ukiddingbitch/ESP32c3/docs/revD.png

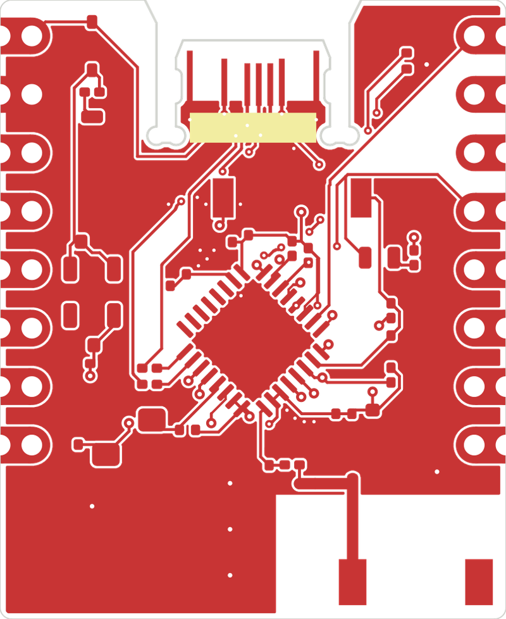
docs/revD.png
