ukiddingbitch/ESP32c3/esp32c3mini-MIFA-F4/esp32c3mini-BOM.csv

Comment | Designator | Footprint | LCSC Part #
GRM033R61A104KE15D | C1 | C_0201_0603Metric | C76934
CL03A105KQ3CSNC | C2 | C_0201_0603Metric | C318541
GRM033R61A104KE15D | C3 | C_0201_0603Metric | C76934
CL03A105KQ3CSNC | C4 | C_0201_0603Metric | C318541
CL05A106MP5NUNC | C5 | C_0402_1005Metric | C315248
GRM0335C1H1R5BA01D | C6 | C_0201_0603Metric | C161414
GRM033R61A104KE15D | C7 | C_0201_0603Metric | C76934
CL03A105KQ3CSNC | C8 | C_0201_0603Metric | C318541
GRM033R61A104KE15D | C9 | C_0201_0603Metric | C76934
CL03A105KQ3CSNC | C10 | C_0201_0603Metric | C318541
GJM0335C1E220JB01D | C11 | C_0201_0603Metric | C237453
GJM0335C1E220JB01D | C12 | C_0201_0603Metric | C237453
CL03A105KQ3CSNC | C13 | C_0201_0603Metric | C318541
CL05A106MP5NUNC | C14 | C_0402_1005Metric | C315248
CL05A106MP5NUNC | C15 | C_0402_1005Metric | C315248
GRM0335C1H1R5BA01D | C16 | C_0201_0603Metric | C161414
KT-0603R | D1 | LED_0603_1608Metric | C2286
KT-0603B | D2 | LED_0603_1608Metric | C2288
BAT60JFILM | D3 | D_SOD-323 | C133103
LQP03TN2N7C02D | L1 | L_0201_0603Metric | C185546
0201WMF1002TEE | R1 | R_0201_0603Metric | C473048
0201WMF1002TEE | R2 | R_0201_0603Metric | C473048
0201WMF1002TEE | R3 | R_0201_0603Metric | C473048
0201WMF1002TEE | R4 | R_0201_0603Metric | C473048
0201WMF5101TEE | R5 | R_0201_0603Metric | C270344
0201WMF5101TEE | R6 | R_0201_0603Metric | C270344
0201WMF5101TEE | R7 | R_0201_0603Metric | C270344
0201WMF5101TEE | R8 | R_0201_0603Metric | C270344
0201WMF220JTEE | R9 | R_0201_0603Metric | C270355
0201WMF220JTEE | R10 | R_0201_0603Metric | C270355
B3U-1000P | SW1 | SW_SPST_B3U-1000P | C231329
B3U-1000P | SW2 | SW_SPST_B3U-1000P | C231329
ESP32-C3FH4 | U1 | QFN-32-1EP_5x5mm_P0.5mm_EP3.45x3.45mm | C2858491
ME6211C33M5G-N | U2 | SOT-23-5 | C82942
X322540MPB4SI | Y1 | Crystal_SMD_3225-4Pin_3.2x2.5mm | C9010
