ukiddingbitch/ESP32c3/esp32c3mini-MIFA-F4/panel/models/D_SOD-323.step

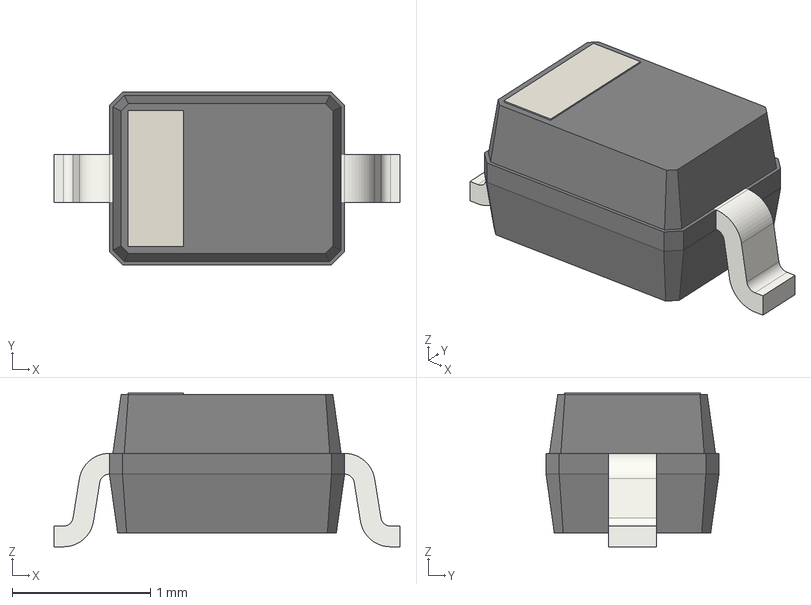
[picture p3: CAD file, 2026-11-11]
esp32c3mini-MIFA-F4/panel/models/D_SOD-323.step
2.50 x 1.25 x 1.11 mm
