ukiddingbitch/ESP32c3/esp32c3mini-MIFA-F4/panel/models/L_0201_0603Metric.step

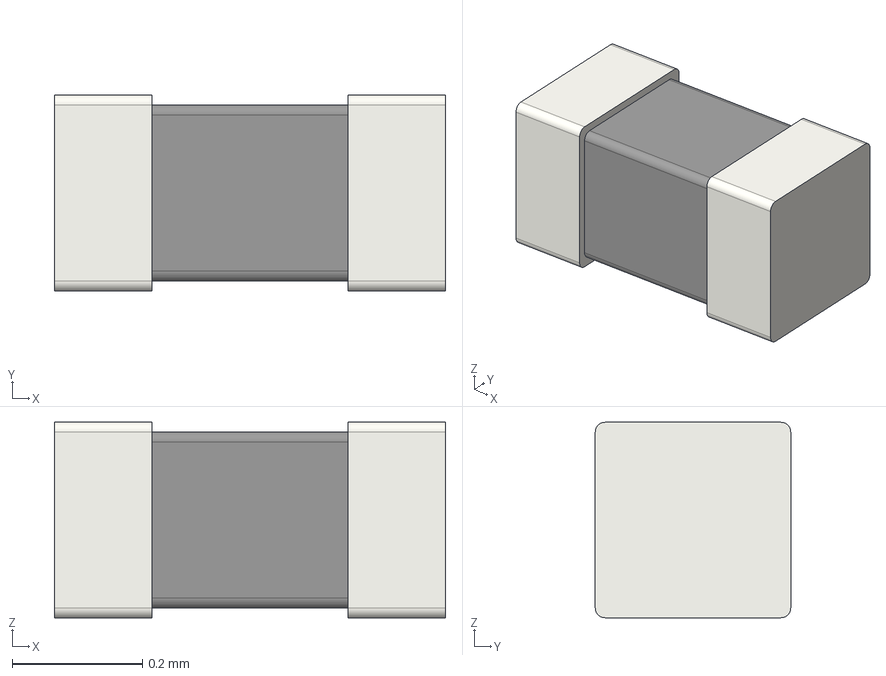
[picture p4: CAD file, 2026-11-11]
esp32c3mini-MIFA-F4/panel/models/L_0201_0603Metric.step
0.6 x 0.3 x 0.3 mm
