ukiddingbitch/ESP32c3/esp32c3mini-MIFA-F4/panel/models/QFN-32-1EP_5x5mm_P0.5mm_EP3.45x3.45mm.step

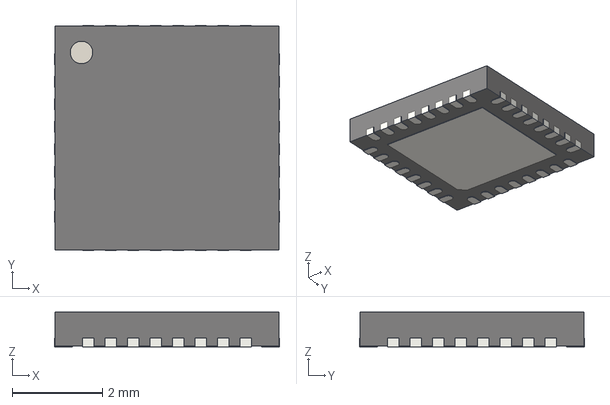
[picture p5: CAD file, 2026-11-11]
esp32c3mini-MIFA-F4/panel/models/QFN-32-1EP_5x5mm_P0.5mm_EP3.45x3.45mm.step
5.00 x 5.00 x 0.77 mm
