ukiddingbitch/ESP32c3/esp32c3mini-MIFA-F4/panel/models/SW_SPST_B3U-1000P.step

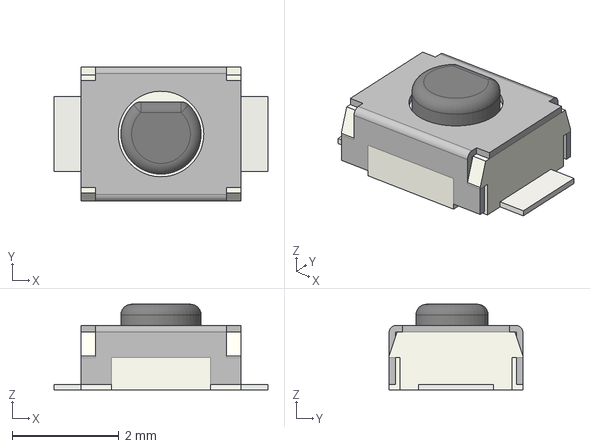
[picture p6: CAD file, 2026-11-11]
esp32c3mini-MIFA-F4/panel/models/SW_SPST_B3U-1000P.step
4.00 x 2.50 x 1.60 mm
