ukiddingbitch/ESP32c3/esp32c3mini-MIFA-F4/panel/models/Crystal_SMD_3225-4Pin_3.2x2.5mm.step

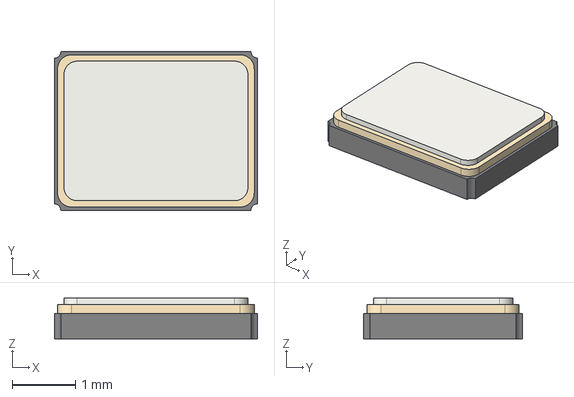
[picture p7: CAD file, 2026-11-11]
esp32c3mini-MIFA-F4/panel/models/Crystal_SMD_3225-4Pin_3.2x2.5mm.step
3.20 x 2.50 x 0.64 mm
