ukiddingbitch/ESP32c3/esp32c3mini-MIFA-F4/panel/models/R_0201_0603Metric.step

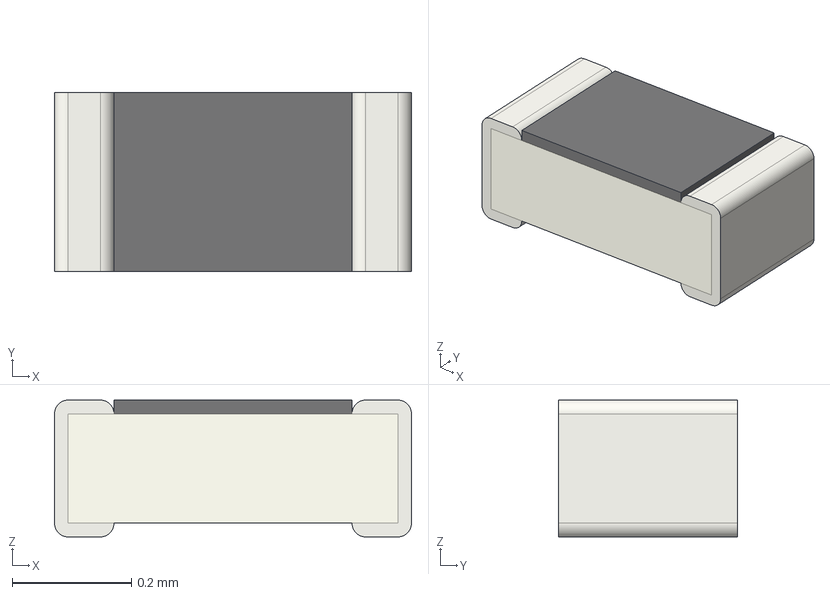
[picture p8: CAD file, 2026-11-11]
esp32c3mini-MIFA-F4/panel/models/R_0201_0603Metric.step
0.6 x 0.3 x 0.23 mm
