ukiddingbitch/ESP32c3/esp32c3mini-MIFA-F4/panel/models/SOT-23-5.step

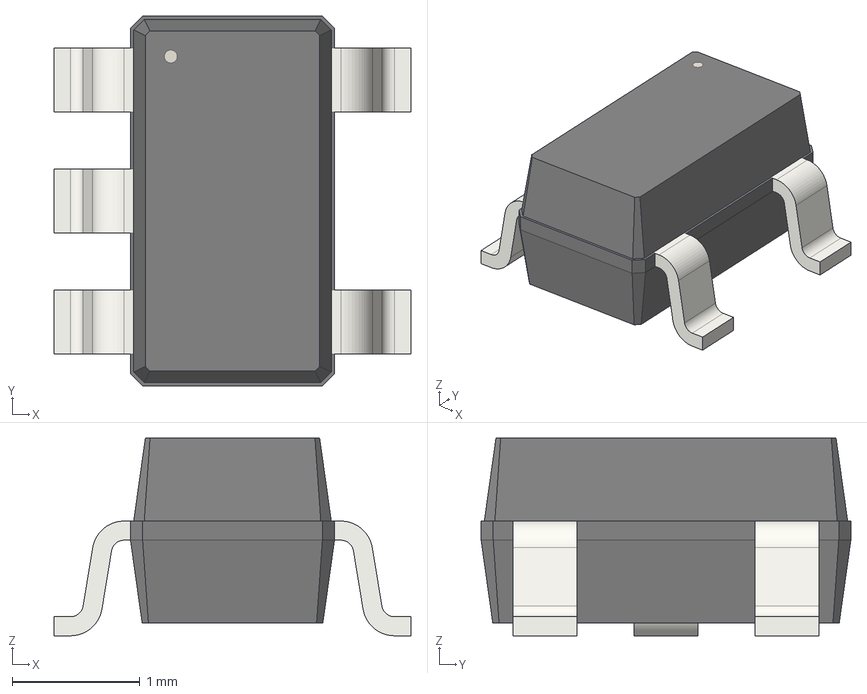
[picture p9: CAD file, 2026-11-11]
esp32c3mini-MIFA-F4/panel/models/SOT-23-5.step
2.80 x 2.90 x 1.55 mm
