ukiddingbitch/ESP32c3/esp32c3mini-MIFA-F4/panel/models/C_0402_1005Metric.step

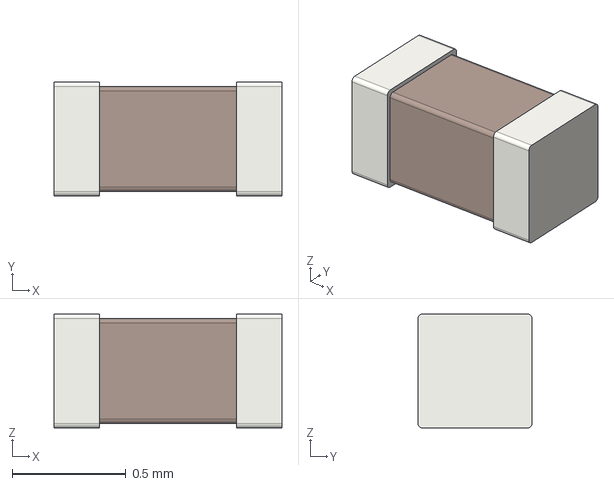
[picture p10: CAD file, 2026-11-11]
esp32c3mini-MIFA-F4/panel/models/C_0402_1005Metric.step
1.00 x 0.5 x 0.5 mm
