ukiddingbitch/ESP32c3/esp32c3mini-MIFA-F4/panel/models/LED_0603_1608Metric.step

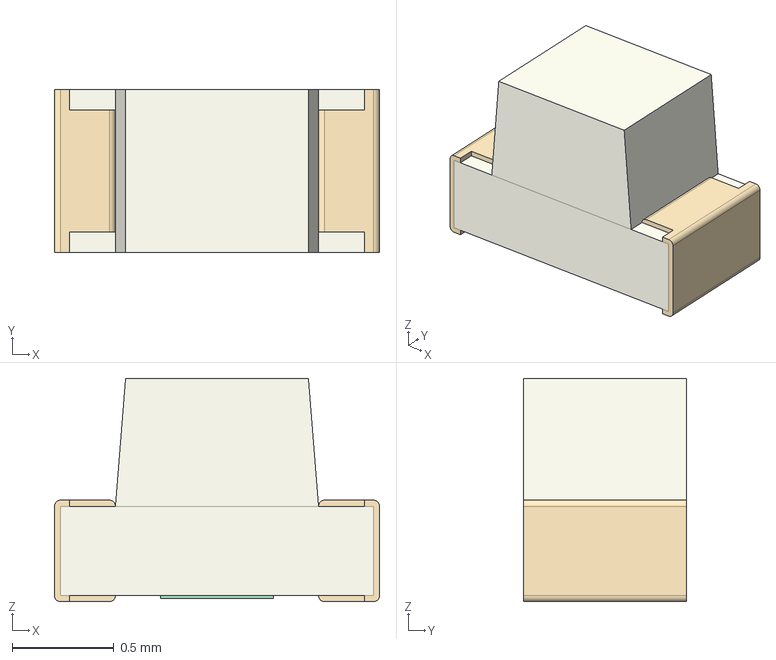
[picture p11: CAD file, 2026-11-11]
esp32c3mini-MIFA-F4/panel/models/LED_0603_1608Metric.step
1.60 x 0.8 x 1.10 mm
