ukiddingbitch/ESP32c3/(list of files, cad)

Other CAD files:
esp32c3mini-MIFA-F4/panel/models/C_0201_0603Metric.step
