ukiddingbitch/ESP32c3/esp32c3mini-MIFA-F4/esp32c3mini.kicad_pcb

## KiCad design esp32c3mini-MIFA-F4/esp32c3mini.kicad_pcb (2026-11-11)

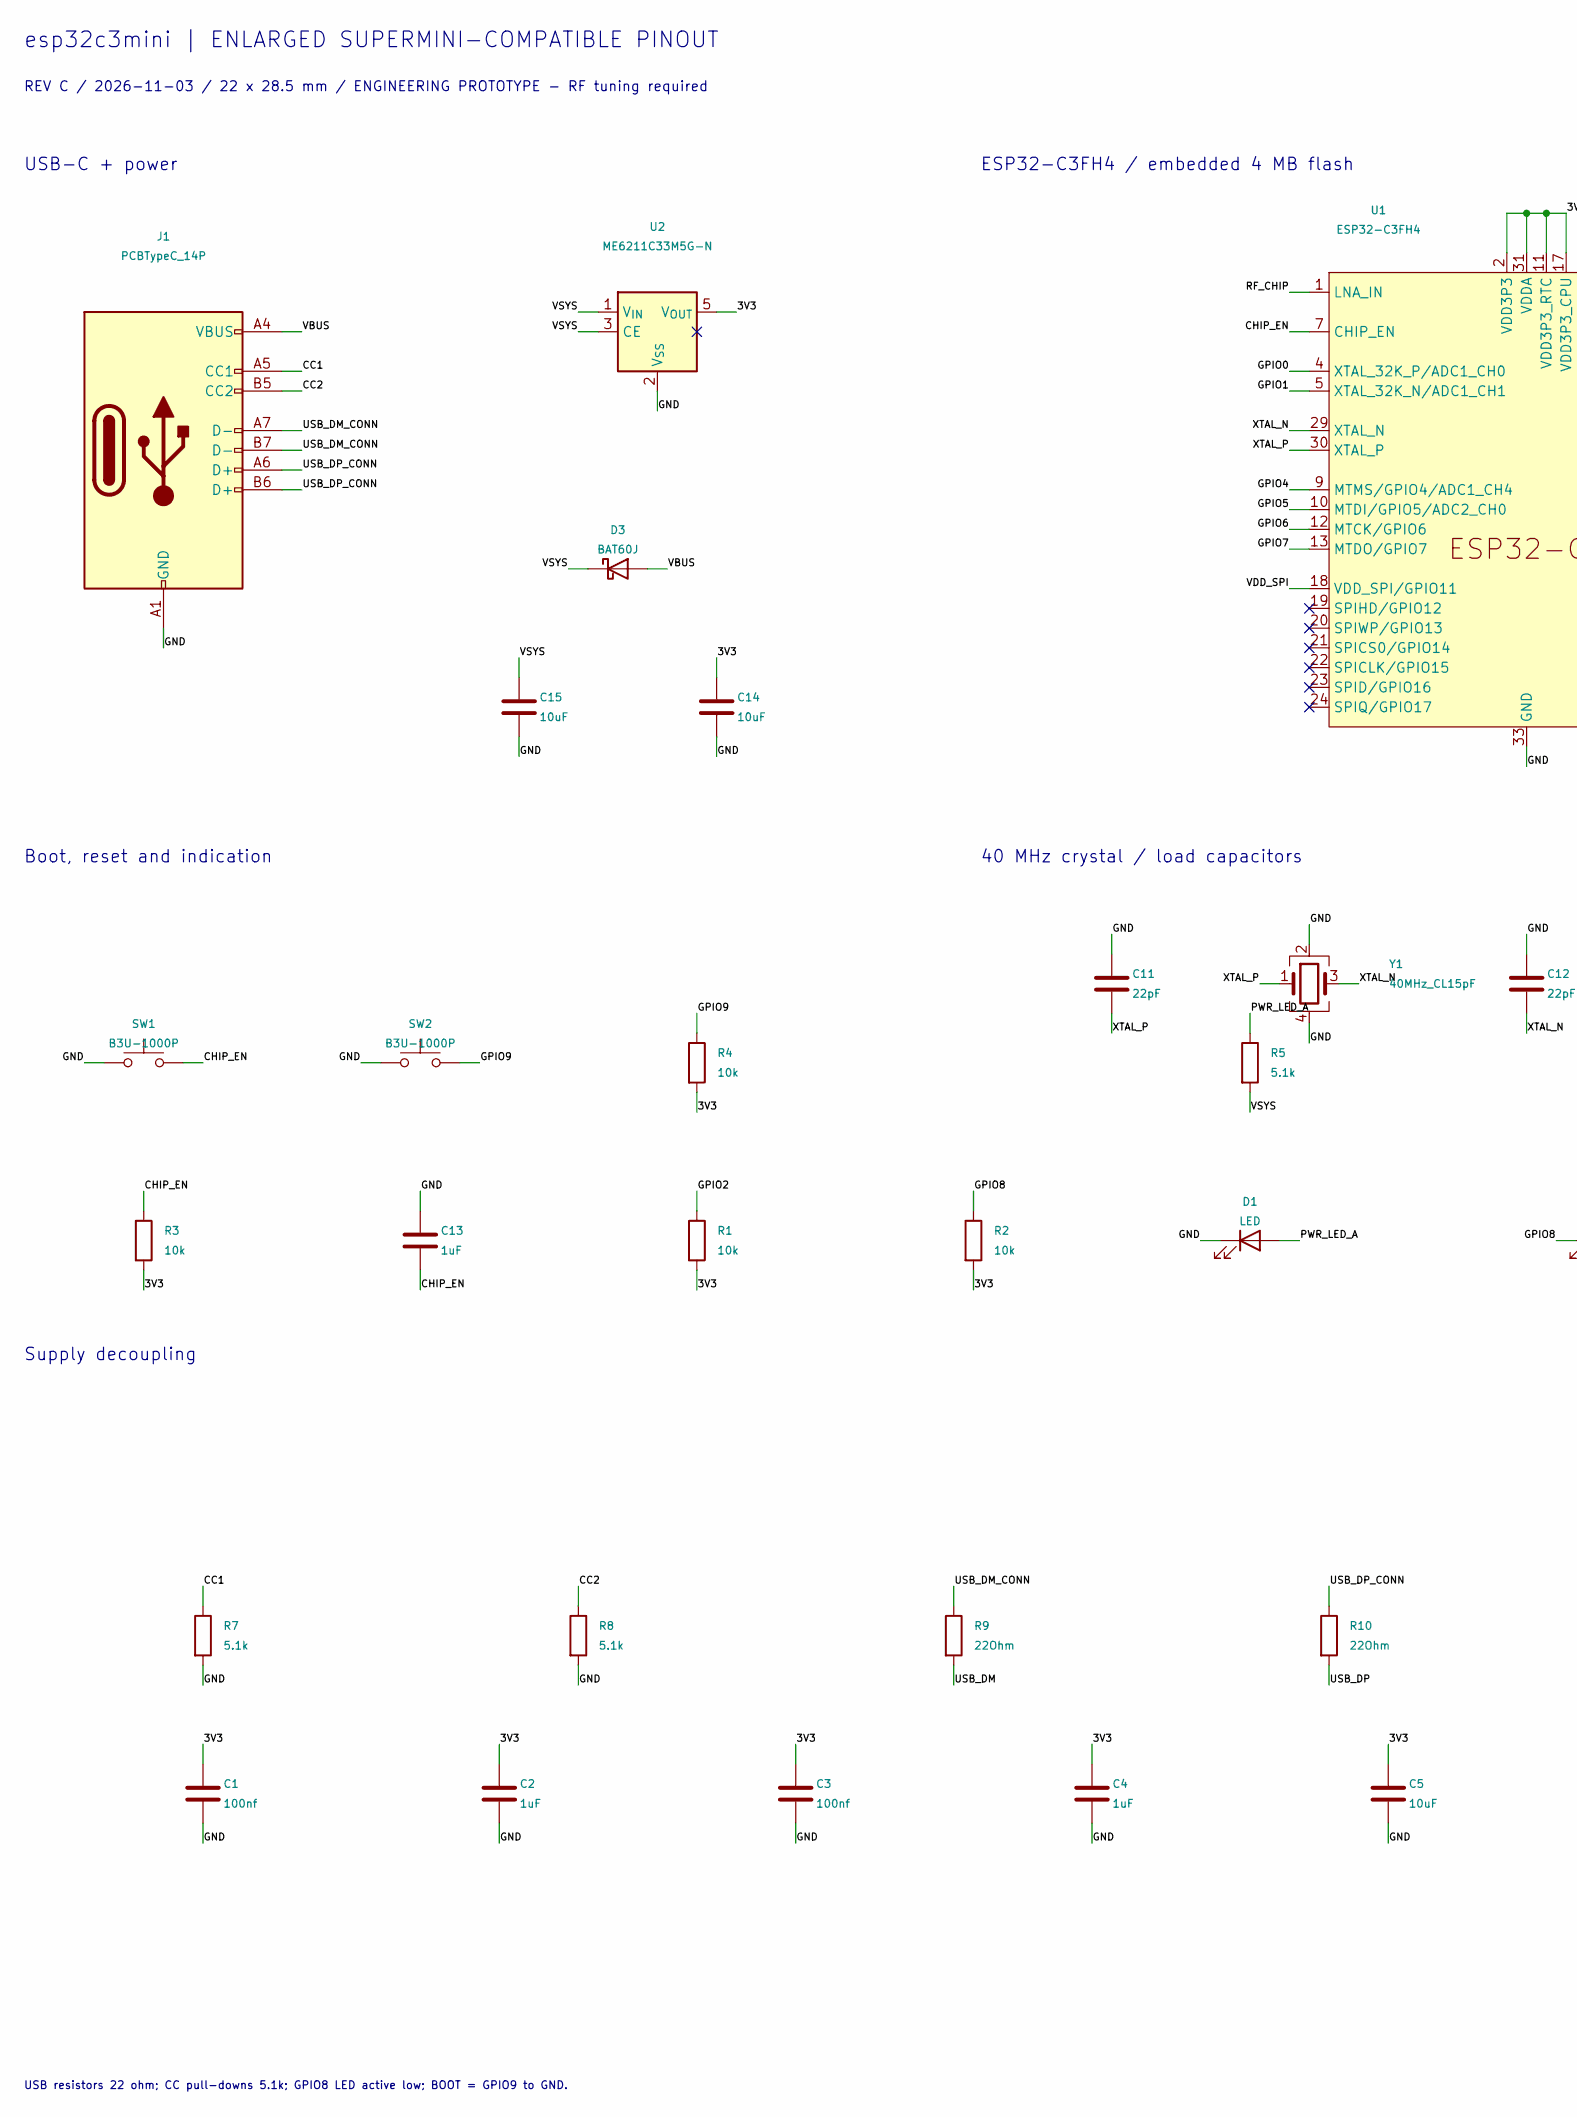
[picture p12: schematic esp32c3mini.kicad_sch, esp32c3mini | REV C enlarged prototype, part in row 1, column 1]

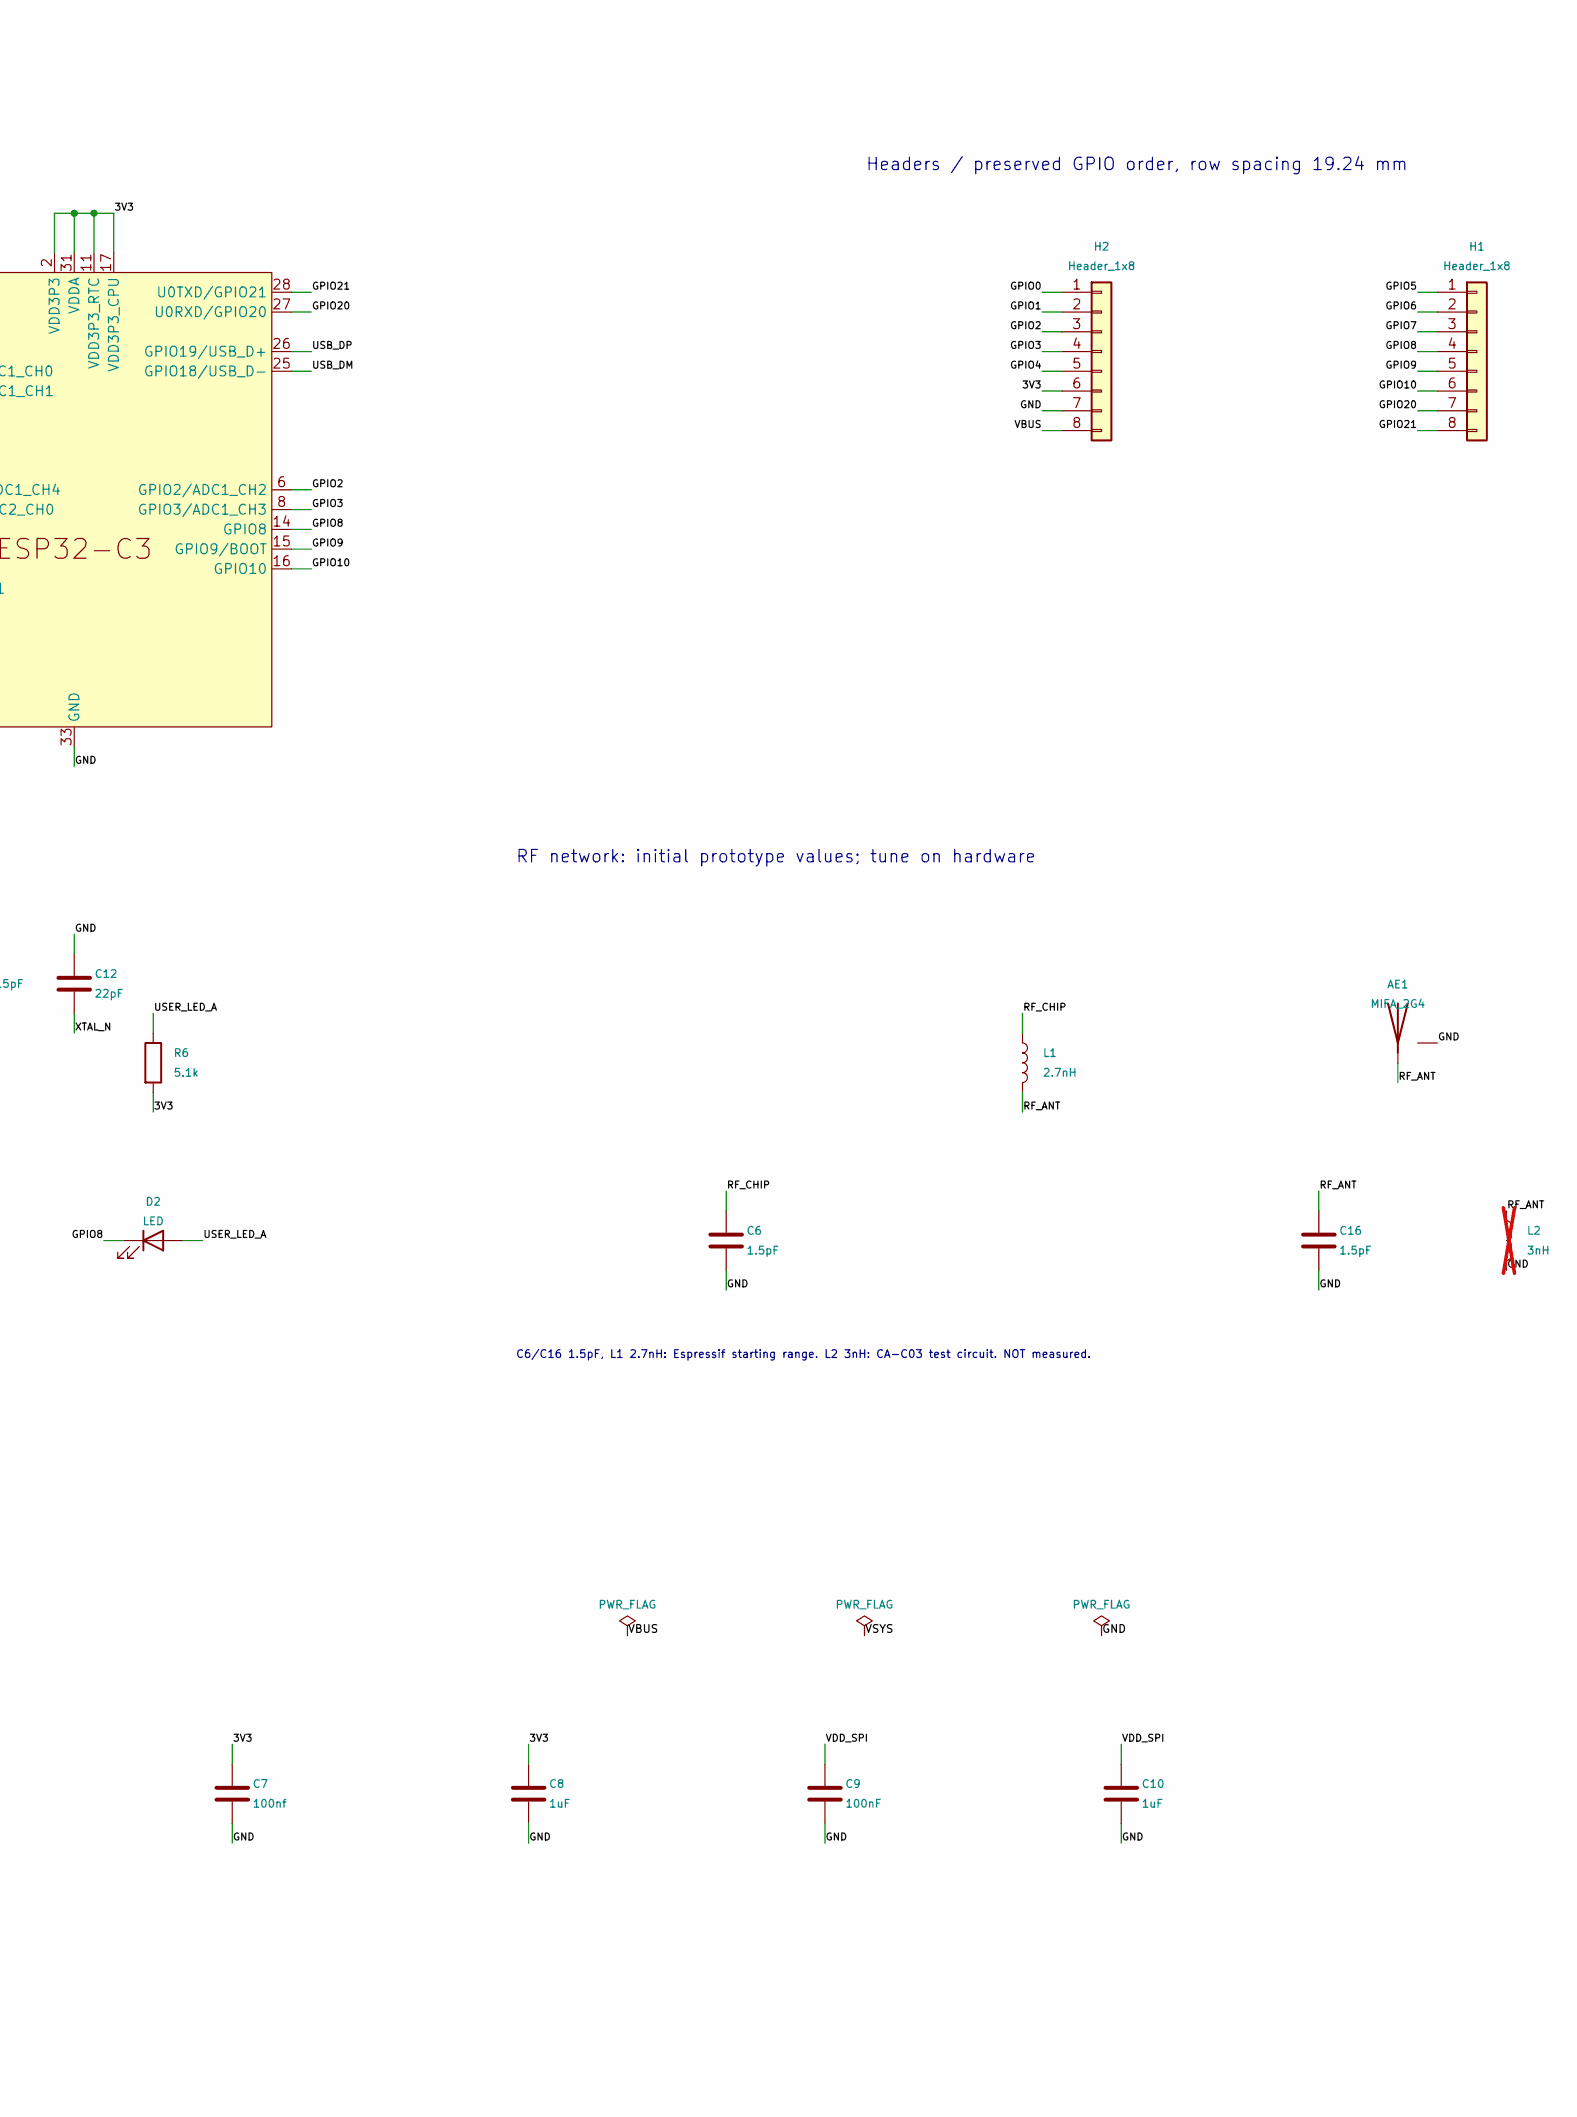
[picture p13: schematic esp32c3mini.kicad_sch, esp32c3mini | REV C enlarged prototype, part in row 1, column 2]

Parts:
AE1: MIFA_2G4; Texas_SWRA117D_2.4GHz_Right
C1, C3, C7: 100nf; C_0201_0603Metric; MPN GRM033R61A104KE15D; LCSC C76934
C2, C4, C8, C10, C13: 1uF; C_0201_0603Metric; MPN CL03A105KQ3CSNC; LCSC C318541
C5, C14, C15: 10uF; C_0402_1005Metric; MPN CL05A106MP5NUNC; LCSC C315248
C6, C16: 1.5pF; C_0201_0603Metric; MPN GRM0335C1H1R5BA01D; LCSC C161414
C9: 100nF; C_0201_0603Metric; MPN GRM033R61A104KE15D; LCSC C76934
C11, C12: 22pF; C_0201_0603Metric; MPN GJM0335C1E220JB01D; LCSC C237453
D1: LED; LED_0603_1608Metric; MPN KT-0603R; LCSC C2286
D2: LED; LED_0603_1608Metric; MPN KT-0603B; LCSC C2288
D3: BAT60J; D_SOD-323; MPN BAT60JFILM; LCSC C133103
H1: Header_1x8; Header_Right
H2: Header_1x8; Header_Left
J1: PCBTypeC_14P; MPN PCB_EDGE_CONTACTS
L1: 2.7nH; L_0201_0603Metric; MPN LQP03TN2N7C02D; LCSC C185546
L2: 3nH; L_0201_0603Metric; MPN LQP03TN3N0C02D; LCSC C162614; not fitted
R1, R2, R3, R4: 10k; R_0201_0603Metric; MPN 0201WMF1002TEE; LCSC C473048
R5, R6, R7, R8: 5.1k; R_0201_0603Metric; MPN 0201WMF5101TEE; LCSC C270344
R9, R10: 22Ohm; R_0201_0603Metric; MPN 0201WMF220JTEE; LCSC C270355
SW1, SW2: B3U-1000P; SW_SPST_B3U-1000P; MPN B3U-1000P; LCSC C231329
U1: ESP32-C3FH4; QFN-32-1EP_5x5mm_P0.5mm_EP3.45x3.45mm; MPN ESP32-C3FH4; LCSC C2858491
U2: ME6211C33M5G-N; SOT-23-5; MPN ME6211C33M5G-N; LCSC C82942
Y1: 40MHz_CL15pF; Crystal_SMD_3225-4Pin_3.2x2.5mm; MPN X322540MPB4SI; LCSC C9010

Connections:
/3V3: C1.1, C2.1, C3.1, C4.1, C5.1, C7.1, C8.1, C14.1, H2.6, R1.2, R2.2, R3.2, R4.2, R6.2, U1.2 (VDD3P3), U1.3 (VDD3P3), U1.11 (VDD3P3_RTC), U1.17 (VDD3P3_CPU), U1.31 (VDDA), U1.32 (VDDA), U2.5 (V_{OUT})
/CC1: J1.A5 (CC1), R7.1
/CC2: J1.B5 (CC2), R8.1
/CHIP_EN: C13.2, R3.1, SW1.2, U1.7 (CHIP_EN)
/GND: AE1.2 (GND), C1.2, C2.2, C3.2, C4.2, C5.2, C6.2, C7.2, C8.2, C9.2, C10.2, C11.1, C12.1, C13.1, C14.2, C15.2, C16.2, D1.1 (K), H2.7, J1.A1 (GND), J1.A12 (GND), J1.B1 (GND), J1.B12 (GND), L2.2, R7.2, R8.2, SW1.1, SW2.1, U1.33 (GND), U2.2 (V_{SS}), Y1.2, Y1.4
/GPIO0: H2.1, U1.4 (XTAL_32K_P/ADC1_CH0)
/GPIO1: H2.2, U1.5 (XTAL_32K_N/ADC1_CH1)
/GPIO2: H2.3, R1.1, U1.6 (GPIO2/ADC1_CH2)
/GPIO3: H2.4, U1.8 (GPIO3/ADC1_CH3)
/GPIO4: H2.5, U1.9 (MTMS/GPIO4/ADC1_CH4)
/GPIO5: H1.1, U1.10 (MTDI/GPIO5/ADC2_CH0)
/GPIO6: H1.2, U1.12 (MTCK/GPIO6)
/GPIO7: H1.3, U1.13 (MTDO/GPIO7)
/GPIO8: D2.1 (K), H1.4, R2.1, U1.14 (GPIO8)
/GPIO9: H1.5, R4.1, SW2.2, U1.15 (GPIO9/BOOT)
/GPIO10: H1.6, U1.16 (GPIO10)
/GPIO20: H1.7, U1.27 (U0RXD/GPIO20)
/GPIO21: H1.8, U1.28 (U0TXD/GPIO21)
/PWR_LED_A: D1.2 (A), R5.1
/RF_ANT: AE1.1 (A), C16.1, L1.2, L2.1
/RF_CHIP: C6.1, L1.1, U1.1 (LNA_IN)
/USB_DM: R9.2, U1.25 (GPIO18/USB_D-)
/USB_DM_CONN: J1.A7 (D-), J1.B7 (D-), R9.1
/USB_DP: R10.2, U1.26 (GPIO19/USB_D+)
/USB_DP_CONN: J1.A6 (D+), J1.B6 (D+), R10.1
/USER_LED_A: D2.2 (A), R6.1
/VBUS: D3.2 (A), H2.8, J1.A4 (VBUS), J1.A9 (VBUS), J1.B4 (VBUS), J1.B9 (VBUS)
/VDD_SPI: C9.1, C10.1, U1.18 (VDD_SPI/GPIO11)
/VSYS: C15.1, D3.1 (K), R5.2, U2.1 (V_{IN}), U2.3 (CE)
/XTAL_N: C12.2, U1.29 (XTAL_N), Y1.3
/XTAL_P: C11.2, U1.30 (XTAL_P), Y1.1

Notes on the sheet:
esp32c3mini | ENLARGED SUPERMINI-COMPATIBLE PINOUT
REV C / 2026-11-03 / 22 x 28.5 mm / ENGINEERING PROTOTYPE - RF tuning required
USB-C + power
ESP32-C3FH4 / embedded 4 MB flash
Headers / preserved GPIO order, row spacing 19.24 mm
Boot, reset and indication
40 MHz crystal / load capacitors
RF network: initial prototype values; tune on hardware
Supply decoupling
C6/C16 1.5pF, L1 2.7nH: Espressif starting range. L2 3nH: CA-C03 test circuit. NOT measured.
USB resistors 22 ohm; CC pull-downs 5.1k; GPIO8 LED active low; BOOT = GPIO9 to GND.

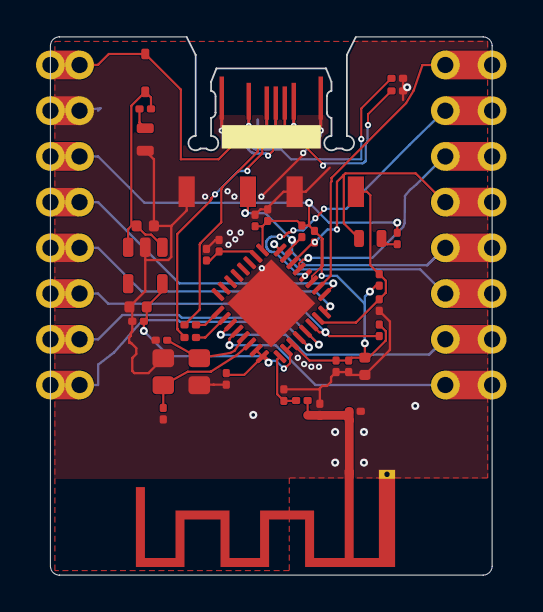
[picture p14: board esp32c3mini.kicad_pcb from above]

Board: 2 copper layers, 24.5 x 29.9 mm, 40 parts (0 on the bottom side), 31 nets.
