ukiddingbitch/ESP32c3/esp32c3mini-MIFA-F4/panel/esp32c3mini-panel.kicad_pcb

## KiCad design esp32c3mini-MIFA-F4/panel/esp32c3mini-panel.kicad_pcb (2026-11-11)

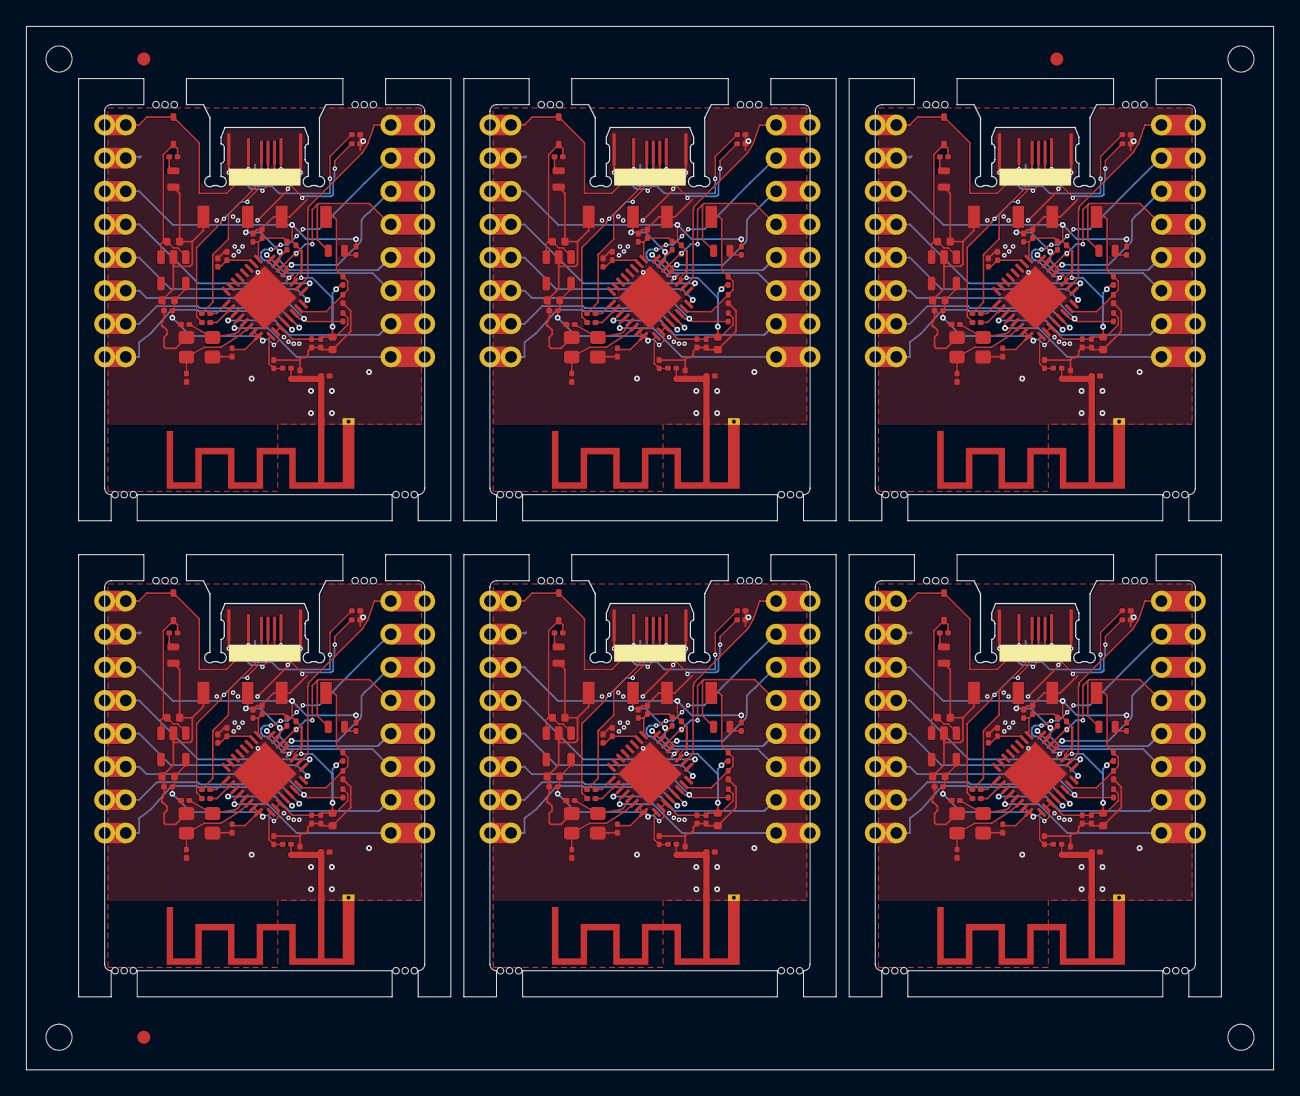
[picture p15: board esp32c3mini-panel.kicad_pcb from above]

Board: 2 copper layers, 95.6 x 80.0 mm, 319 parts (0 on the bottom side), 186 nets.

Parts:
AE101, AE201, AE301, AE401, AE501, AE601: MIFA_2G4; Texas_SWRA117D_2.4GHz_Right
C101, C103, C107, C201, C203, C207, C301, C303, C307, C401, C403, C407, C501, C503, C507, C601, C603, C607: 100nf; C_0201_0603Metric
C102, C104, C108, C110, C113, C202, C204, C208, C210, C213, C302, C304, C308, C310, C313, C402, C404, C408, C410, C413, C502, C504, C508, C510, C513, C602, C604, C608, C610, C613: 1uF; C_0201_0603Metric
C105, C114, C115, C205, C214, C215, C305, C314, C315, C405, C414, C415, C505, C514, C515, C605, C614, C615: 10uF; C_0402_1005Metric
C106, C116, C206, C216, C306, C316, C406, C416, C506, C516, C606, C616: 1.5pF; C_0201_0603Metric
C109, C209, C309, C409, C509, C609: 100nF; C_0201_0603Metric
C111, C112, C211, C212, C311, C312, C411, C412, C511, C512, C611, C612: 22pF; C_0201_0603Metric
D101, D102, D201, D202, D301, D302, D401, D402, D501, D502, D601, D602: LED; LED_0603_1608Metric
D103, D203, D303, D403, D503, D603: BAT60J; D_SOD-323
FID1, FID2, FID3: Fiducial
H101, H201, H301, H401, H501, H601: Header_1x8; Header_Right
H102, H202, H302, H402, H502, H602: Header_1x8; Header_Left
J101, J201, J301, J401, J501, J601: PCBTypeC_14P
L101, L201, L301, L401, L501, L601: 2.7nH; L_0201_0603Metric
L102, L202, L302, L402, L502, L602: 3nH; L_0201_0603Metric
MB1_0.23_135_0, MB1_0.23_135_1, MB1_0.23_135_2, MB1_3.365_106_0, MB1_3.365_106_1, MB1_3.365_106_2, MB1_18.635_106_0, MB1_18.635_106_1, MB1_18.635_106_2, MB1_21.77_135_0, MB1_21.77_135_1, MB1_21.77_135_2, MB2_0.23_135_0, MB2_0.23_135_1, MB2_0.23_135_2, MB2_3.365_106_0, MB2_3.365_106_1, MB2_3.365_106_2, MB2_18.635_106_0, MB2_18.635_106_1, MB2_18.635_106_2, MB2_21.77_135_0, MB2_21.77_135_1, MB2_21.77_135_2, MB3_0.23_135_0, MB3_0.23_135_1, MB3_0.23_135_2, MB3_3.365_106_0, MB3_3.365_106_1, MB3_3.365_106_2, MB3_18.635_106_0, MB3_18.635_106_1, MB3_18.635_106_2, MB3_21.77_135_0, MB3_21.77_135_1, MB3_21.77_135_2, MB4_0.23_172_0, MB4_0.23_172_1, MB4_0.23_172_2, MB4_3.365_142_0, MB4_3.365_142_1, MB4_3.365_142_2, MB4_18.635_142_0, MB4_18.635_142_1, MB4_18.635_142_2, MB4_21.77_172_0, MB4_21.77_172_1, MB4_21.77_172_2, MB5_0.23_172_0, MB5_0.23_172_1, MB5_0.23_172_2, MB5_3.365_142_0, MB5_3.365_142_1, MB5_3.365_142_2, MB5_18.635_142_0, MB5_18.635_142_1, MB5_18.635_142_2, MB5_21.77_172_0, MB5_21.77_172_1, MB5_21.77_172_2, MB6_0.23_172_0, MB6_0.23_172_1, MB6_0.23_172_2, MB6_3.365_142_0, MB6_3.365_142_1, MB6_3.365_142_2, MB6_18.635_142_0, MB6_18.635_142_1, MB6_18.635_142_2, MB6_21.77_172_0, MB6_21.77_172_1, MB6_21.77_172_2: NPTH; NPTH_0.5
R101, R102, R103, R104, R201, R202, R203, R204, R301, R302, R303, R304, R401, R402, R403, R404, R501, R502, R503, R504, R601, R602, R603, R604: 10k; R_0201_0603Metric
R105, R106, R107, R108, R205, R206, R207, R208, R305, R306, R307, R308, R405, R406, R407, R408, R505, R506, R507, R508, R605, R606, R607, R608: 5.1k; R_0201_0603Metric
R109, R110, R209, R210, R309, R310, R409, R410, R509, R510, R609, R610: 22Ohm; R_0201_0603Metric
SW101, SW102, SW201, SW202, SW301, SW302, SW401, SW402, SW501, SW502, SW601, SW602: B3U-1000P; SW_SPST_B3U-1000P
TH1, TH2, TH3, TH4: NPTH; NPTH_2
U101, U201, U301, U401, U501, U601: ESP32-C3FH4; QFN-32-1EP_5x5mm_P0.5mm_EP3.45x3.45mm
U102, U202, U302, U402, U502, U602: ME6211C33M5G-N; SOT-23-5
Y101, Y201, Y301, Y401, Y501, Y601: 40MHz_CL15pF; Crystal_SMD_3225-4Pin_3.2x2.5mm

Connections:
/B1/3V3: C101.1, C102.1, C103.1, C104.1, C105.1, C107.1, C108.1, C114.1, H102.6, R101.2, R102.2, R103.2, R104.2, R106.2, U101.2, U101.3, U101.11, U101.17, U101.31, U101.32, U102.5
/B1/CC1: J101.A5, R107.1
/B1/CC2: J101.B5, R108.1
/B1/CHIP_EN: C113.2, R103.1, SW101.2, U101.7
/B1/GND: AE101.2, C101.2, C102.2, C103.2, C104.2, C105.2, C106.2, C107.2, C108.2, C109.2, C110.2, C111.1, C112.1, C113.1, C114.2, C115.2, C116.2, D101.1, H102.7, J101.A1, J101.A12, J101.B1, J101.B12, L102.2, R107.2, R108.2, SW101.1, SW102.1, U101.33, U102.2, Y101.2, Y101.4
/B1/GPIO0: H102.1, U101.4
/B1/GPIO1: H102.2, U101.5
/B1/GPIO2: H102.3, R101.1, U101.6
/B1/GPIO3: H102.4, U101.8
/B1/GPIO4: H102.5, U101.9
/B1/GPIO5: H101.1, U101.10
/B1/GPIO6: H101.2, U101.12
/B1/GPIO7: H101.3, U101.13
/B1/GPIO8: D102.1, H101.4, R102.1, U101.14
/B1/GPIO9: H101.5, R104.1, SW102.2, U101.15
/B1/GPIO10: H101.6, U101.16
/B1/GPIO20: H101.7, U101.27
/B1/GPIO21: H101.8, U101.28
/B1/PWR_LED_A: D101.2, R105.1
/B1/RF_ANT: AE101.1, C116.1, L101.2, L102.1
/B1/RF_CHIP: C106.1, L101.1, U101.1
/B1/USB_DM: R109.2, U101.25
/B1/USB_DM_CONN: J101.A7, J101.B7, R109.1
/B1/USB_DP: R110.2, U101.26
/B1/USB_DP_CONN: J101.A6, J101.B6, R110.1
/B1/USER_LED_A: D102.2, R106.1
/B1/VBUS: D103.2, H102.8, J101.A4, J101.A9, J101.B4, J101.B9
/B1/VDD_SPI: C109.1, C110.1, U101.18
/B1/VSYS: C115.1, D103.1, R105.2, U102.1, U102.3
/B1/XTAL_N: C112.2, U101.29, Y101.3
/B1/XTAL_P: C111.2, U101.30, Y101.1
/B2/3V3: C201.1, C202.1, C203.1, C204.1, C205.1, C207.1, C208.1, C214.1, H202.6, R201.2, R202.2, R203.2, R204.2, R206.2, U201.2, U201.3, U201.11, U201.17, U201.31, U201.32, U202.5
/B2/CC1: J201.A5, R207.1
/B2/CC2: J201.B5, R208.1
/B2/CHIP_EN: C213.2, R203.1, SW201.2, U201.7
/B2/GND: AE201.2, C201.2, C202.2, C203.2, C204.2, C205.2, C206.2, C207.2, C208.2, C209.2, C210.2, C211.1, C212.1, C213.1, C214.2, C215.2, C216.2, D201.1, H202.7, J201.A1, J201.A12, J201.B1, J201.B12, L202.2, R207.2, R208.2, SW201.1, SW202.1, U201.33, U202.2, Y201.2, Y201.4
/B2/GPIO0: H202.1, U201.4
/B2/GPIO1: H202.2, U201.5
/B2/GPIO2: H202.3, R201.1, U201.6
/B2/GPIO3: H202.4, U201.8
/B2/GPIO4: H202.5, U201.9
/B2/GPIO5: H201.1, U201.10
/B2/GPIO6: H201.2, U201.12
/B2/GPIO7: H201.3, U201.13
/B2/GPIO8: D202.1, H201.4, R202.1, U201.14
/B2/GPIO9: H201.5, R204.1, SW202.2, U201.15
/B2/GPIO10: H201.6, U201.16
/B2/GPIO20: H201.7, U201.27
/B2/GPIO21: H201.8, U201.28
/B2/PWR_LED_A: D201.2, R205.1
/B2/RF_ANT: AE201.1, C216.1, L201.2, L202.1
/B2/RF_CHIP: C206.1, L201.1, U201.1
/B2/USB_DM: R209.2, U201.25
/B2/USB_DM_CONN: J201.A7, J201.B7, R209.1
/B2/USB_DP: R210.2, U201.26
/B2/USB_DP_CONN: J201.A6, J201.B6, R210.1
/B2/USER_LED_A: D202.2, R206.1
/B2/VBUS: D203.2, H202.8, J201.A4, J201.A9, J201.B4, J201.B9
/B2/VDD_SPI: C209.1, C210.1, U201.18
/B2/VSYS: C215.1, D203.1, R205.2, U202.1, U202.3
/B2/XTAL_N: C212.2, U201.29, Y201.3
/B2/XTAL_P: C211.2, U201.30, Y201.1
/B3/3V3: C301.1, C302.1, C303.1, C304.1, C305.1, C307.1, C308.1, C314.1, H302.6, R301.2, R302.2, R303.2, R304.2, R306.2, U301.2, U301.3, U301.11, U301.17, U301.31, U301.32, U302.5
/B3/CC1: J301.A5, R307.1
/B3/CC2: J301.B5, R308.1
/B3/CHIP_EN: C313.2, R303.1, SW301.2, U301.7
/B3/GND: AE301.2, C301.2, C302.2, C303.2, C304.2, C305.2, C306.2, C307.2, C308.2, C309.2, C310.2, C311.1, C312.1, C313.1, C314.2, C315.2, C316.2, D301.1, H302.7, J301.A1, J301.A12, J301.B1, J301.B12, L302.2, R307.2, R308.2, SW301.1, SW302.1, U301.33, U302.2, Y301.2, Y301.4
/B3/GPIO0: H302.1, U301.4
/B3/GPIO1: H302.2, U301.5
/B3/GPIO2: H302.3, R301.1, U301.6
/B3/GPIO3: H302.4, U301.8
/B3/GPIO4: H302.5, U301.9
/B3/GPIO5: H301.1, U301.10
/B3/GPIO6: H301.2, U301.12
/B3/GPIO7: H301.3, U301.13
/B3/GPIO8: D302.1, H301.4, R302.1, U301.14
/B3/GPIO9: H301.5, R304.1, SW302.2, U301.15
/B3/GPIO10: H301.6, U301.16
/B3/GPIO20: H301.7, U301.27
/B3/GPIO21: H301.8, U301.28
/B3/PWR_LED_A: D301.2, R305.1
/B3/RF_ANT: AE301.1, C316.1, L301.2, L302.1
/B3/RF_CHIP: C306.1, L301.1, U301.1
/B3/USB_DM: R309.2, U301.25
/B3/USB_DM_CONN: J301.A7, J301.B7, R309.1
/B3/USB_DP: R310.2, U301.26
/B3/USB_DP_CONN: J301.A6, J301.B6, R310.1
/B3/USER_LED_A: D302.2, R306.1
/B3/VBUS: D303.2, H302.8, J301.A4, J301.A9, J301.B4, J301.B9
/B3/VDD_SPI: C309.1, C310.1, U301.18
/B3/VSYS: C315.1, D303.1, R305.2, U302.1, U302.3
/B3/XTAL_N: C312.2, U301.29, Y301.3
/B3/XTAL_P: C311.2, U301.30, Y301.1
/B4/3V3: C401.1, C402.1, C403.1, C404.1, C405.1, C407.1, C408.1, C414.1, H402.6, R401.2, R402.2, R403.2, R404.2, R406.2, U401.2, U401.3, U401.11, U401.17, U401.31, U401.32, U402.5
/B4/CC1: J401.A5, R407.1
/B4/CC2: J401.B5, R408.1
/B4/CHIP_EN: C413.2, R403.1, SW401.2, U401.7
/B4/GND: AE401.2, C401.2, C402.2, C403.2, C404.2, C405.2, C406.2, C407.2, C408.2, C409.2, C410.2, C411.1, C412.1, C413.1, C414.2, C415.2, C416.2, D401.1, H402.7, J401.A1, J401.A12, J401.B1, J401.B12, L402.2, R407.2, R408.2, SW401.1, SW402.1, U401.33, U402.2, Y401.2, Y401.4
/B4/GPIO0: H402.1, U401.4
/B4/GPIO1: H402.2, U401.5
/B4/GPIO2: H402.3, R401.1, U401.6
/B4/GPIO3: H402.4, U401.8
/B4/GPIO4: H402.5, U401.9
/B4/GPIO5: H401.1, U401.10
/B4/GPIO6: H401.2, U401.12
/B4/GPIO7: H401.3, U401.13
/B4/GPIO8: D402.1, H401.4, R402.1, U401.14
/B4/GPIO9: H401.5, R404.1, SW402.2, U401.15
/B4/GPIO10: H401.6, U401.16
/B4/GPIO20: H401.7, U401.27
/B4/GPIO21: H401.8, U401.28
/B4/PWR_LED_A: D401.2, R405.1
/B4/RF_ANT: AE401.1, C416.1, L401.2, L402.1
/B4/RF_CHIP: C406.1, L401.1, U401.1
/B4/USB_DM: R409.2, U401.25
/B4/USB_DM_CONN: J401.A7, J401.B7, R409.1
/B4/USB_DP: R410.2, U401.26
/B4/USB_DP_CONN: J401.A6, J401.B6, R410.1
/B4/USER_LED_A: D402.2, R406.1
/B4/VBUS: D403.2, H402.8, J401.A4, J401.A9, J401.B4, J401.B9
/B4/VDD_SPI: C409.1, C410.1, U401.18
/B4/VSYS: C415.1, D403.1, R405.2, U402.1, U402.3
/B4/XTAL_N: C412.2, U401.29, Y401.3
/B4/XTAL_P: C411.2, U401.30, Y401.1
/B5/3V3: C501.1, C502.1, C503.1, C504.1, C505.1, C507.1, C508.1, C514.1, H502.6, R501.2, R502.2, R503.2, R504.2, R506.2, U501.2, U501.3, U501.11, U501.17, U501.31, U501.32, U502.5
/B5/CC1: J501.A5, R507.1
/B5/CC2: J501.B5, R508.1
/B5/CHIP_EN: C513.2, R503.1, SW501.2, U501.7
/B5/GND: AE501.2, C501.2, C502.2, C503.2, C504.2, C505.2, C506.2, C507.2, C508.2, C509.2, C510.2, C511.1, C512.1, C513.1, C514.2, C515.2, C516.2, D501.1, H502.7, J501.A1, J501.A12, J501.B1, J501.B12, L502.2, R507.2, R508.2, SW501.1, SW502.1, U501.33, U502.2, Y501.2, Y501.4
/B5/GPIO0: H502.1, U501.4
/B5/GPIO1: H502.2, U501.5
/B5/GPIO2: H502.3, R501.1, U501.6
/B5/GPIO3: H502.4, U501.8
/B5/GPIO4: H502.5, U501.9
/B5/GPIO5: H501.1, U501.10
/B5/GPIO6: H501.2, U501.12
/B5/GPIO7: H501.3, U501.13
/B5/GPIO8: D502.1, H501.4, R502.1, U501.14
/B5/GPIO9: H501.5, R504.1, SW502.2, U501.15
/B5/GPIO10: H501.6, U501.16
/B5/GPIO20: H501.7, U501.27
/B5/GPIO21: H501.8, U501.28
/B5/PWR_LED_A: D501.2, R505.1
/B5/RF_ANT: AE501.1, C516.1, L501.2, L502.1
/B5/RF_CHIP: C506.1, L501.1, U501.1
/B5/USB_DM: R509.2, U501.25
/B5/USB_DM_CONN: J501.A7, J501.B7, R509.1
/B5/USB_DP: R510.2, U501.26
/B5/USB_DP_CONN: J501.A6, J501.B6, R510.1
/B5/USER_LED_A: D502.2, R506.1
/B5/VBUS: D503.2, H502.8, J501.A4, J501.A9, J501.B4, J501.B9
/B5/VDD_SPI: C509.1, C510.1, U501.18
/B5/VSYS: C515.1, D503.1, R505.2, U502.1, U502.3
/B5/XTAL_N: C512.2, U501.29, Y501.3
/B5/XTAL_P: C511.2, U501.30, Y501.1
/B6/3V3: C601.1, C602.1, C603.1, C604.1, C605.1, C607.1, C608.1, C614.1, H602.6, R601.2, R602.2, R603.2, R604.2, R606.2, U601.2, U601.3, U601.11, U601.17, U601.31, U601.32, U602.5
/B6/CC1: J601.A5, R607.1
/B6/CC2: J601.B5, R608.1
/B6/CHIP_EN: C613.2, R603.1, SW601.2, U601.7
/B6/GND: AE601.2, C601.2, C602.2, C603.2, C604.2, C605.2, C606.2, C607.2, C608.2, C609.2, C610.2, C611.1, C612.1, C613.1, C614.2, C615.2, C616.2, D601.1, H602.7, J601.A1, J601.A12, J601.B1, J601.B12, L602.2, R607.2, R608.2, SW601.1, SW602.1, U601.33, U602.2, Y601.2, Y601.4
/B6/GPIO0: H602.1, U601.4
/B6/GPIO1: H602.2, U601.5
/B6/GPIO2: H602.3, R601.1, U601.6
/B6/GPIO3: H602.4, U601.8
/B6/GPIO4: H602.5, U601.9
/B6/GPIO5: H601.1, U601.10
/B6/GPIO6: H601.2, U601.12
/B6/GPIO7: H601.3, U601.13
/B6/GPIO8: D602.1, H601.4, R602.1, U601.14
/B6/GPIO9: H601.5, R604.1, SW602.2, U601.15
/B6/GPIO10: H601.6, U601.16
/B6/GPIO20: H601.7, U601.27
/B6/GPIO21: H601.8, U601.28
/B6/PWR_LED_A: D601.2, R605.1
/B6/RF_ANT: AE601.1, C616.1, L601.2, L602.1
/B6/RF_CHIP: C606.1, L601.1, U601.1
/B6/USB_DM: R609.2, U601.25
/B6/USB_DM_CONN: J601.A7, J601.B7, R609.1
/B6/USB_DP: R610.2, U601.26
/B6/USB_DP_CONN: J601.A6, J601.B6, R610.1
/B6/USER_LED_A: D602.2, R606.1
/B6/VBUS: D603.2, H602.8, J601.A4, J601.A9, J601.B4, J601.B9
/B6/VDD_SPI: C609.1, C610.1, U601.18
/B6/VSYS: C615.1, D603.1, R605.2, U602.1, U602.3
/B6/XTAL_N: C612.2, U601.29, Y601.3
/B6/XTAL_P: C611.2, U601.30, Y601.1
