ukiddingbitch/ESP32c3/(notices)

Notices in the files:
esp32c3mini-MIFA-F4/panel/models/LED_0603_1608Metric.step:
Copyright (C) 2018, kicad StepUp
This work is licensed under the [Creative Commons CC-BY-SA 4.0 License](https://creativecommons.org/licenses/by-sa/4.0/legalcode),
with the following exception:
To the extent that the creation of electronic designs that use 'Licensed Material' can be considered to be 'Adapted Material',
You are free to use the library data in your own projects without the obligation to share your project files under this or any other license agreement.
esp32c3mini-MIFA-F4/panel/models/C_0402_1005Metric.step:
Copyright (C) 2017, kicad StepUp
esp32c3mini-MIFA-F4/panel/models/QFN-32-1EP_5x5mm_P0.5mm_EP3.45x3.45mm.step:
This program is free software: you can redistribute it and/or modify
it under the terms of the GNU General Public License as published by
the Free Software Foundation, either version 3 of the License, or
any later version.
itself might be covered by the GNU General Public License.
esp32c3mini-MIFA-F4/panel/models/SOT-23-5.step:
Copyright (C) 2025, KiCAD
This work is licensed under the
[Creative Commons CC-BY-SA 4.0 License](https://creativecommons.org/licenses/by-sa/4.0/legalcode),
project files under this or any other license agreement. However, if you wish to distribute
